gmoorman/sddec24-13/README_files/A_Brief_Excerpt_on_Mixed_Signal_Circuits_for_Xschem.pdf

# A Brief Excerpt on Mixed Signal Circuits for Xschem

# Synthesize Digital Components

## Update toolchain and PDKs

The first step is to ensure the environment dependencies are updated. At the time of writing, it can be confirmed this mixed-signal method works with Toolchain version 1.0.4. In terms of the PDK, setup detailed in this document was used: Precheck Guide. (https://sddec24-13.sd.ece.iastate.edu/Precheck_reram%20precheck.pdf)

## Create digital components with OpenLane

Next, harden your digital macro with OpenLane. In this environment, the easiest way would be to follow the typical digital flow for the Carvel User Harness. To do so, you can clone and setup the following Caravel User Harness git repo: https://github.com/efabless/caravel.

Assuming the repository and PDKs have been setup properly you’ll want to ensure the following environment variables have been set:

You should then be able to follow the digital workflow as stated in the OpenLane documentation here: https://openlane.readthedocs.io/en/latest/usage/index.html
And this document from sddec23-06 detailing the digital flow using the Caravel User Harness: https://sddec23-06.sd.ece.iastate.edu/reports/492/UserGuide.pdf

## Verilog to Combinational Logic Circuitry

This process is relatively straight-forward and a guide by Stefan Schippers, the author of Xschem, can be found in this Slack discussion here: https://open-source-silicon.slack.com/archives/C017P3RAD42/p1715774213341429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 (https://open-source-silicon.slack.com/archives/C017P3RAD42/p1715774213341429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)

The following is a brief guide based on that video.

1) Once you’ve run through the digital design process, OpenLane should have spat out a gate-level Verilog netlist. This can generally be found in the following directory:

/caravel_user_project/openlane/MODULE/runs/MODULE/results/final /verilog/gl/

2) From here, there may be two files.
MODULE.nl.v and MODULE.v
You’ll want to take the powered netlist, and this is usually MODULE.v. You can verify this by comparing the two files. The unpowered netlist should have the following comment.
3) Copy this netlist file into your Xschem directory (or wherever your .xschemrc)
4) Run awk script with the Verilog netlist with the following command ./make_sky130_sch_from_verilog.awk MODULE.v
This will generate the schematic and subsequent symbol for your module.
You should see something similar to the following should the operation be successful.

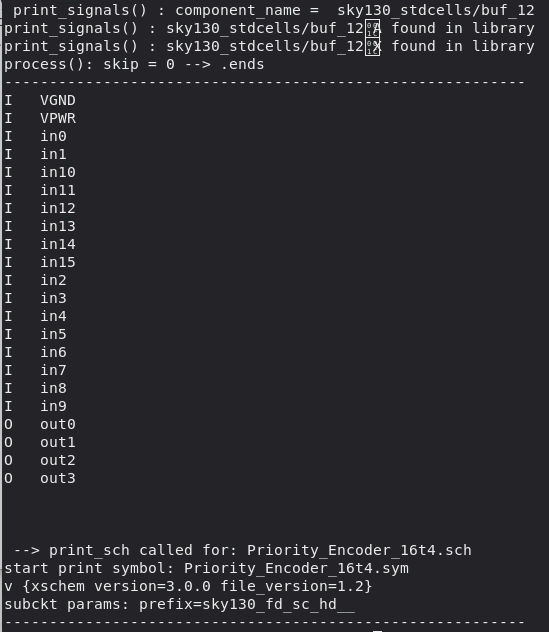
[picture p27: figure]

5) Open your schematic in Xschem and remove non-functional cells like fillers and taps as such:
- Select all non-functional cells by “CTRL+F” and filling out the following form
- Once selected, you can delete these cells

6) Open your symbol and change your symbol type from “primitive” to “subcircuit”
- You can edit this attribute by pressing “Q” in the .sym folder to pull up the following dialog

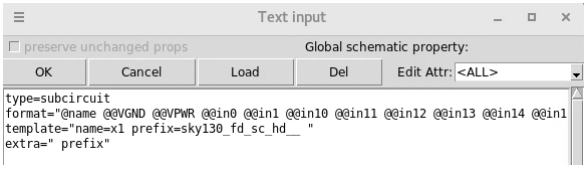
[picture p28: figure]

7) Finally, when you place the attributed symbol in a testbench, ensure that you place a code.sym with the following input:

name=STDCELLS
only_toplevel=true
format="tcleval( @value )"
value=" ** opencircuitdesign pdks install .include
$::SKYWATER_STDCELLS/sky130_fd_sc_hd.spice "
spice_ignore=false
