gmoorman/sddec24-13/README_files/sddec24-13_final_492_presentaion.pdf

# ReRAM Compute ASIC

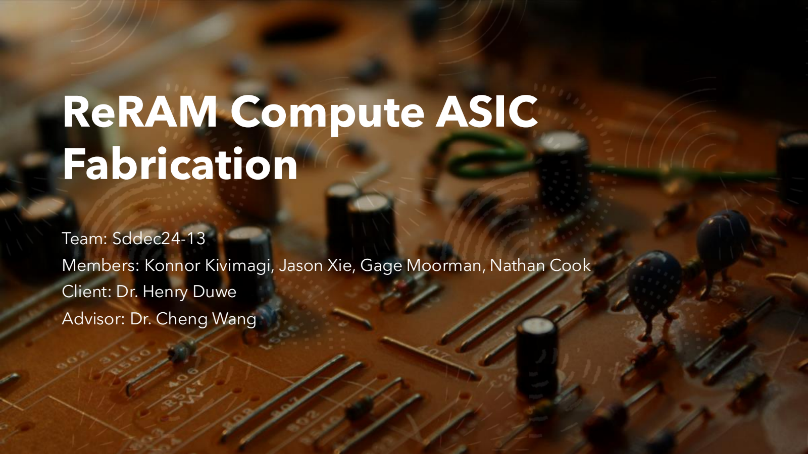
[picture p35: page 1]

# Fabrication

Team: Sddec24-13
Members: Konnor Kivimagi, Jason Xie, Gage Moorman, Nathan Cook Client: Dr. Henry Duwe
Advisor: Dr. Cheng Wang

# Project Overview

- Problem
- ReRAM is an emerging memory technology
- Not commercially available
- Has the potential to be used in more efficient in-memory computation
- Goals
- Create a research vehicle for silicon proving in memory computation utilizing ReRAM
- Create documentation on our process and on solutions to common issues

# Broad context

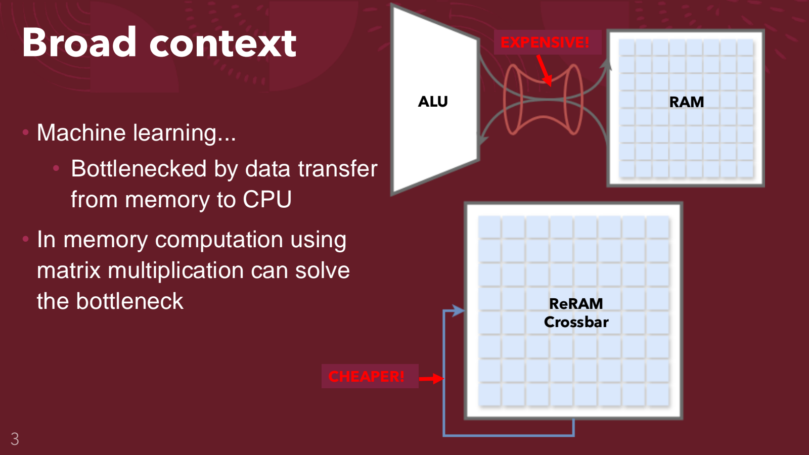
[picture p36: page 3]

- Machine learning...
- Bottlenecked by data transfer from memory to CPU
- In memory computation using matrix multiplication can solve the bottleneck
ALU | RAM

EXPENSIVE!

ReRAM
Crossbar

CHEAPER!

# ReRAM

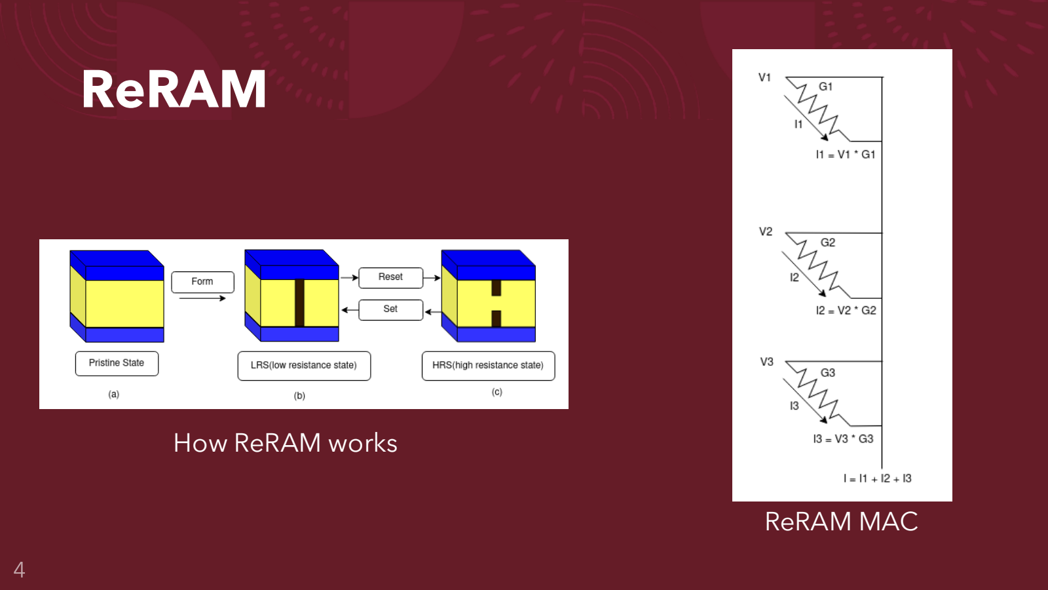
[picture p37: page 4]

How ReRAM works

ReRAM MAC

# ReRAM pros and cons

Pros | Cons
High memory density | Variation due to random noise
Non-volatile memory | Different manufacturing process
Low power consumption | Not an established technology
Ability to scale to smaller processes

Still an active research area, hope to further enable solutions with this test chip

# Users

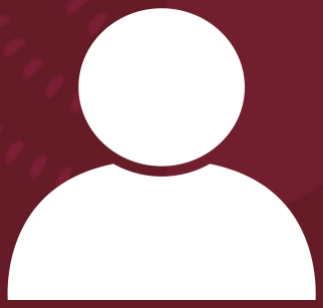
[picture p38: figure]

- Graduate Students
- Documentation on Efabless process and tool flow for use in research settings
- Undergrad Students
- Easy to follow lab documentation
- Gain the ability to bring up a chip in parallel with their regular coursework
- Professor Duwe and Professor Wang
- Practical example of a crossbar for research and testing
- Provide valuable resources for the co-curricular chip program

# Requirements

- Functional Requirements
- Design an 8x8 ReRAM crossbar that can perform matrix vector multiplication
- Create an ADC with a sufficiently high resolution to distinguish between all possible MAC output values
- 40 MHz clock speed
- Fit within 1/8th the provided area
- Characterization of peripheral circuits
- Non-functional Requirements
- Project Documentation
- Bring-up plan for testing the fabricated chip

# Efabless Fabrication

Efabless runs a shuttle program every
few months
- Low-cost development
- Projects are required to be open-source
- Uses open Skywater 130nm process

Design Process
- Create a design
- Integrate it into the caravel harness
- Submit for fabrication

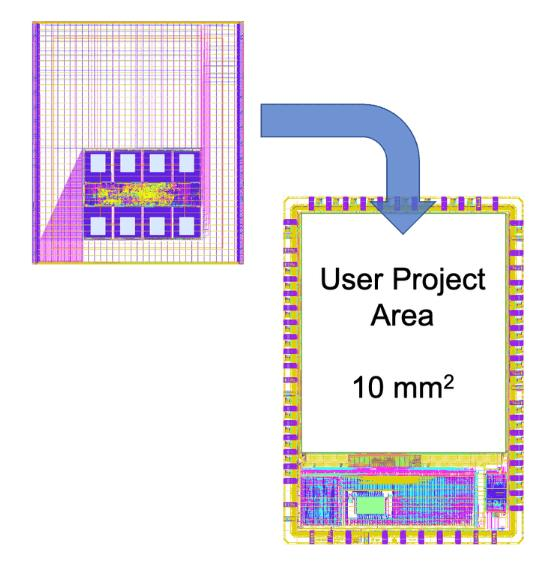
[picture p39: figure]

Source 1

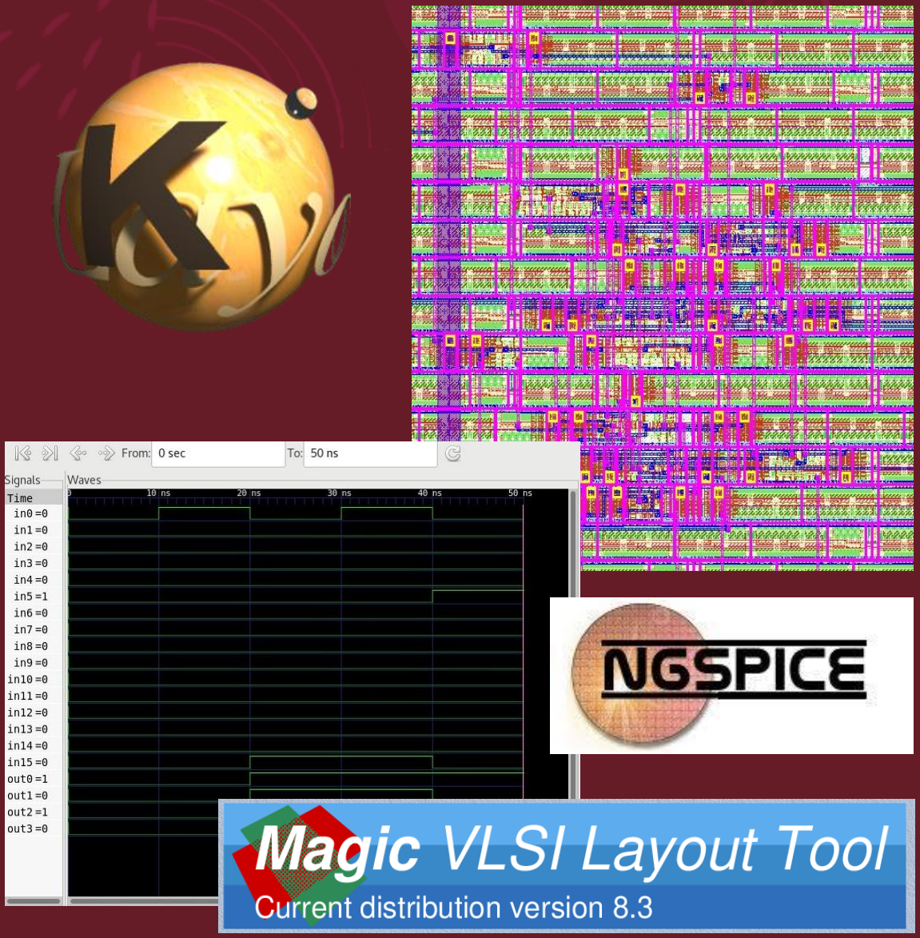
[picture p40: figure]

# Design Tools

- Xschem - Schematic capture
- Netgen – Used for LVS
- Ngspice – Spice simulator
- Magic - Layout creation
- Klayout – GDSII viewer
- GTKwave – Verilog waveforms

# Efabless Design

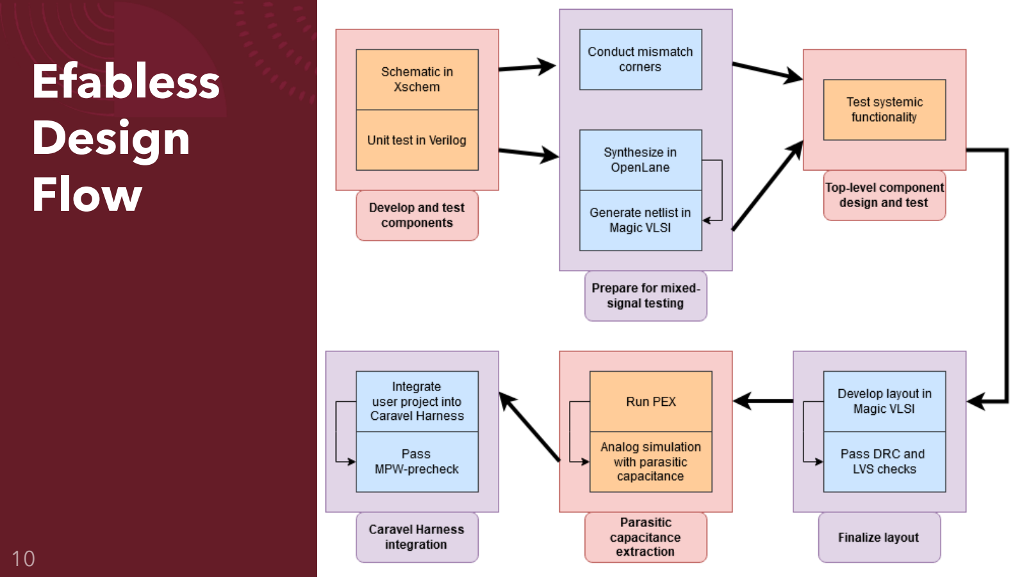
[picture p41: page 10]

# Flow

10

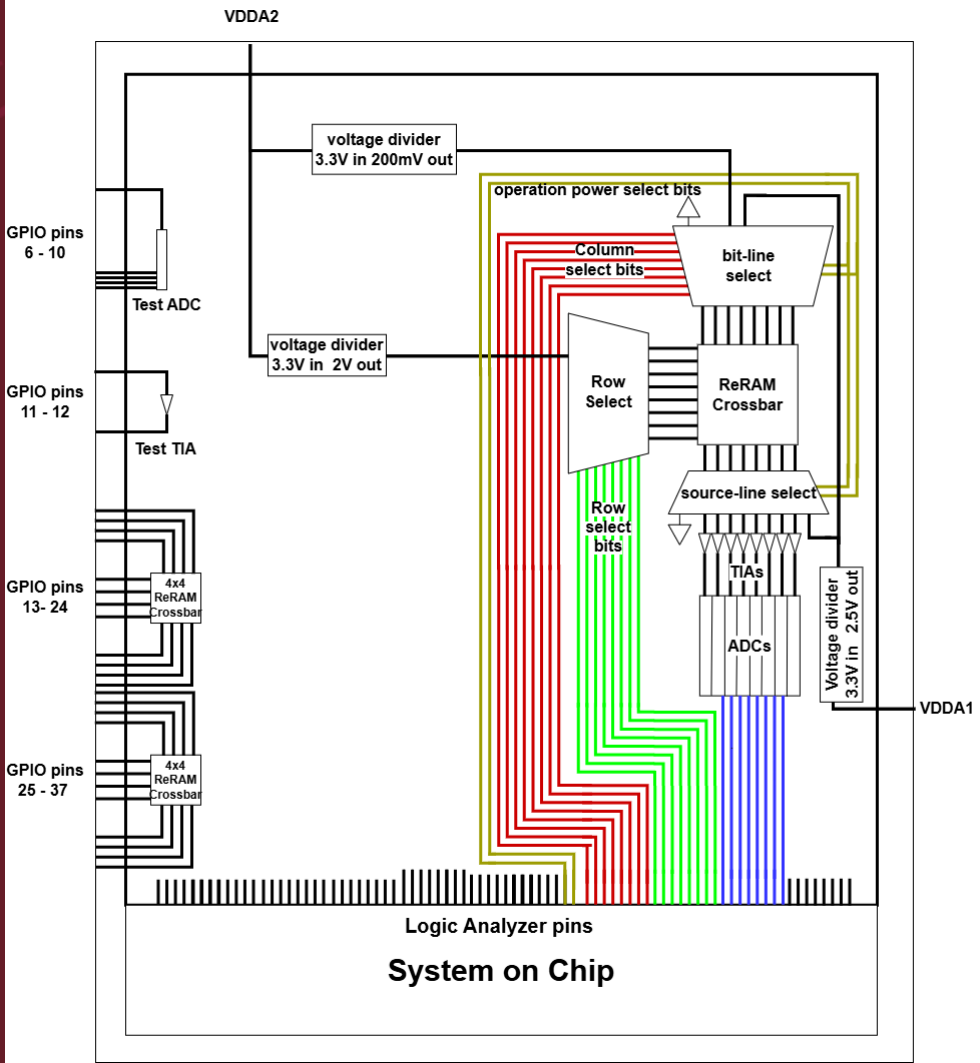
[picture p42: figure]

- Control circuits – Logic analyzer, row, power, and column select, decides what operation is performed
- DAC – used during standalone operation
- Power select – selects the voltage values being used
- ADC and TIA network – Convert ReRAM analog output to a logic analyzer compatible digital output

# Top level design

## Crossbar

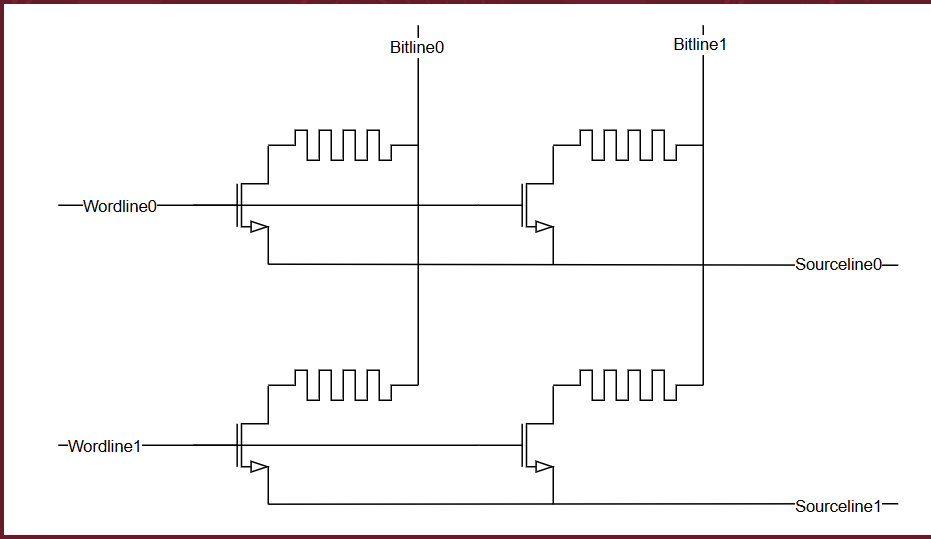
[picture p43: figure]

- 8x8 used for our
design

# The ReRAM cell

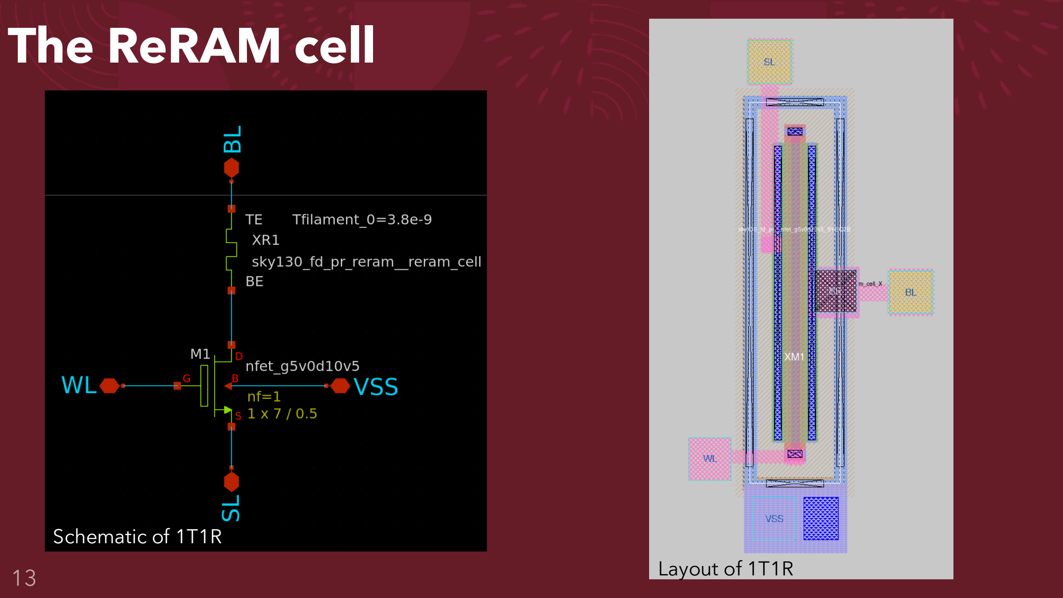
[picture p44: page 13]

Schematic of 1T1R
Layout of 1T1R

# ReRAM operations

Write – set
- Positive voltage
across the cell
- Wordline selects row


ReRAM set

# ReRAM operations

Write – reset
- Negative voltage
across the cell
- Wordline selects row

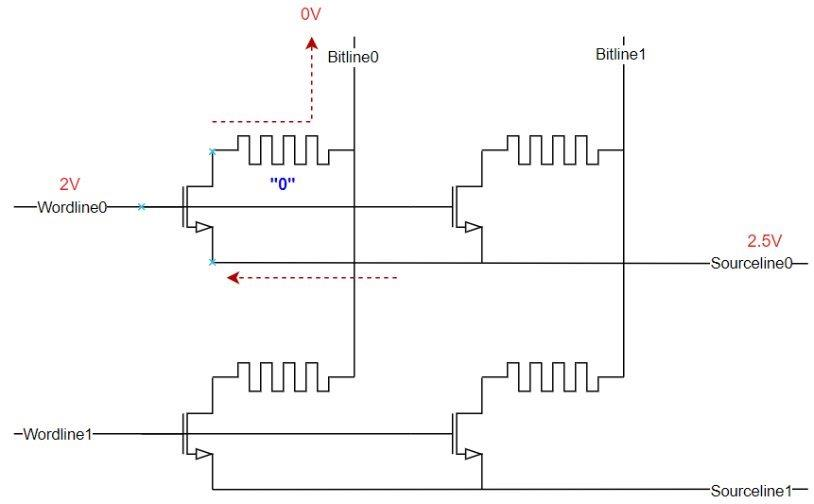
[picture p45: figure]

ReRAM reset

# ReRAM Operations

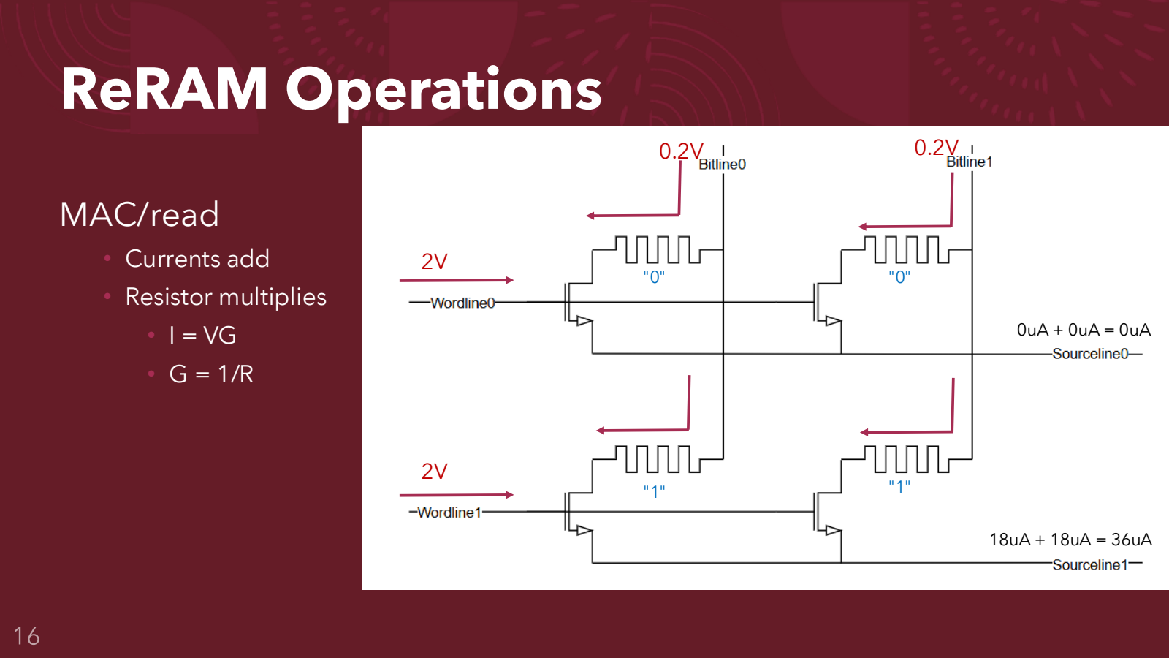
[picture p46: page 16]

MAC/read

- Currents add
- Resistor multiplies
- I = VG
- G = 1/R

2V

2V

0.2V

"1"

0.2V

"1"

"0" | "0"

0uA + 0uA = 0uA

18uA + 18uA = 36uA

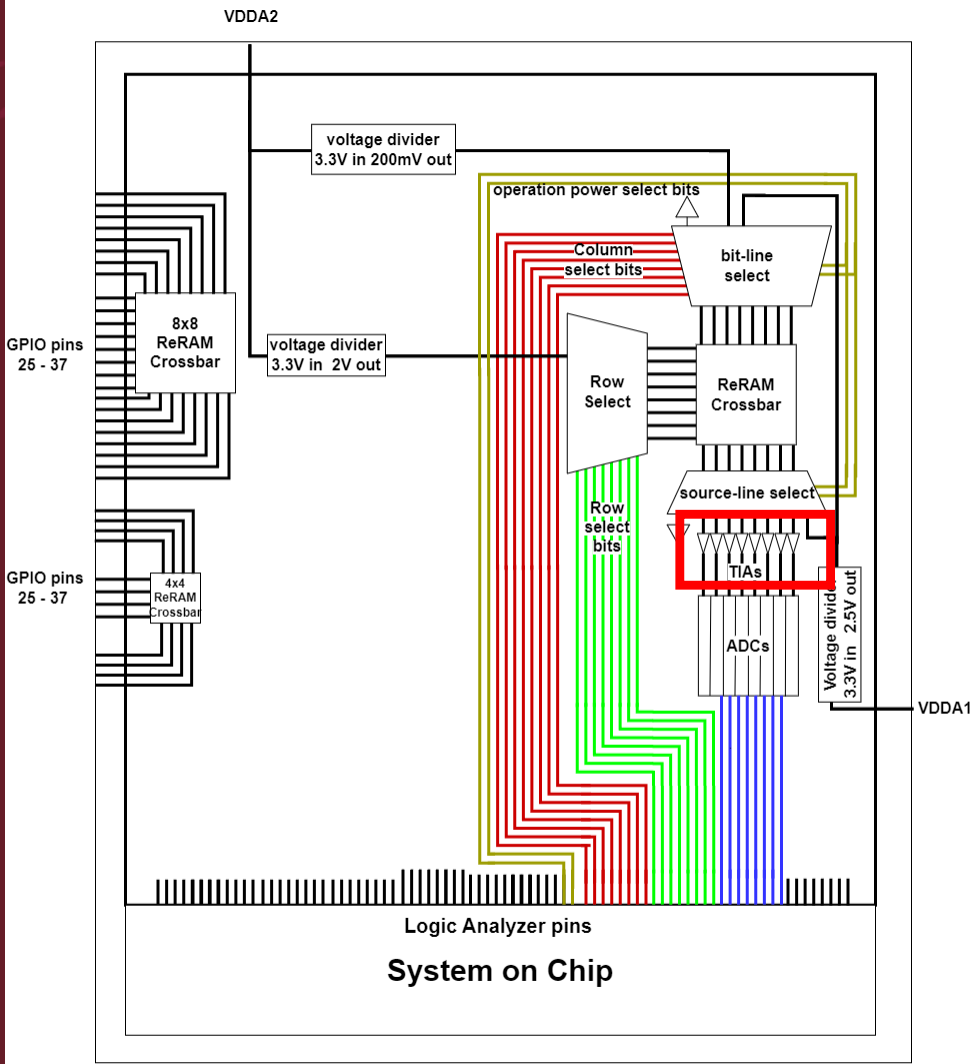
[picture p47: figure]

- Converts input current to output voltage
- Desired TIA characteristics
- Linear output
- High trans-impedance gain
- Low input impedance

## Trans-Impedance Amplifier (TIA)

## Trans-Impedance Amplifier (TIA)

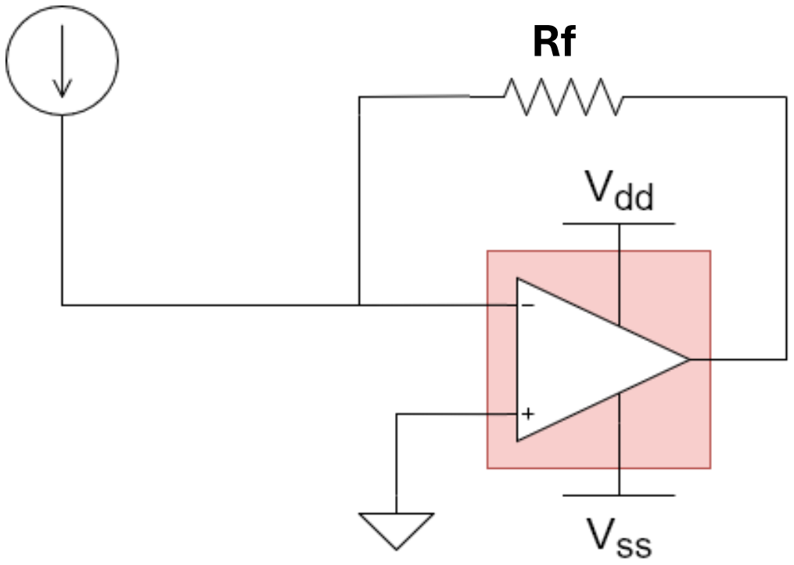
[picture p48: figure]

- Op-Amp Architecure Considerations
- 2 stage
- Increased Gain
- BW dependant on first

# Trans-Impedance Amplifier (TIA)

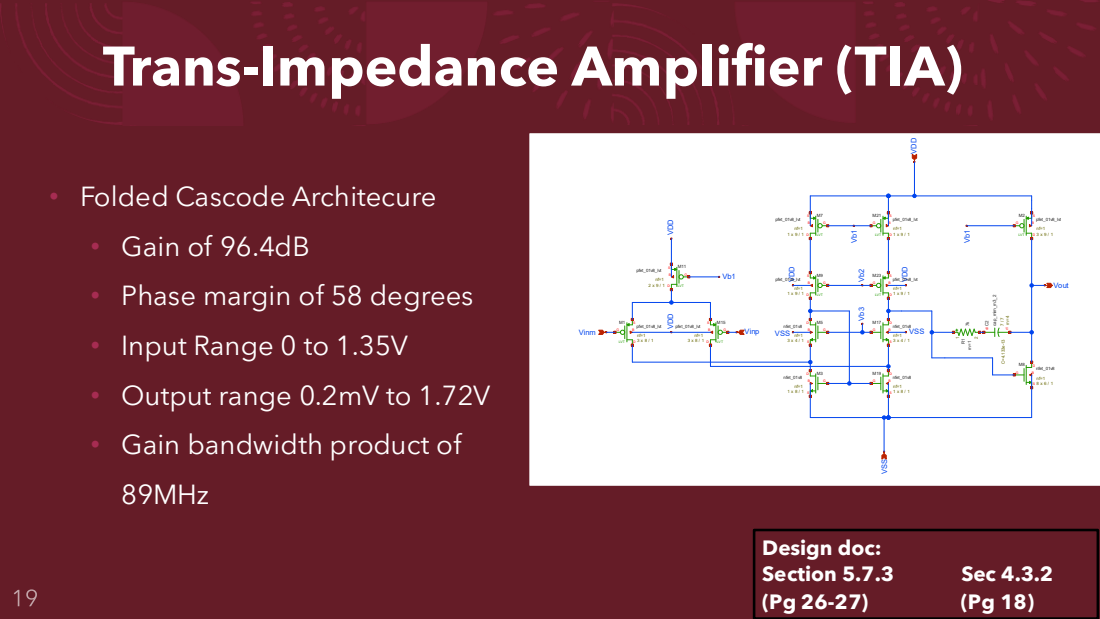
[picture p49: page 19]
Design doc:; Section 5.7.3; Sec 4.3.2

• Folded Cascode Architecure
• Gain of 96.4dB
• Phase margin of 58 degrees
• Input Range 0 to 1.35V
• Output range 0.2mV to 1.72V
• Gain bandwidth product of
89MHz

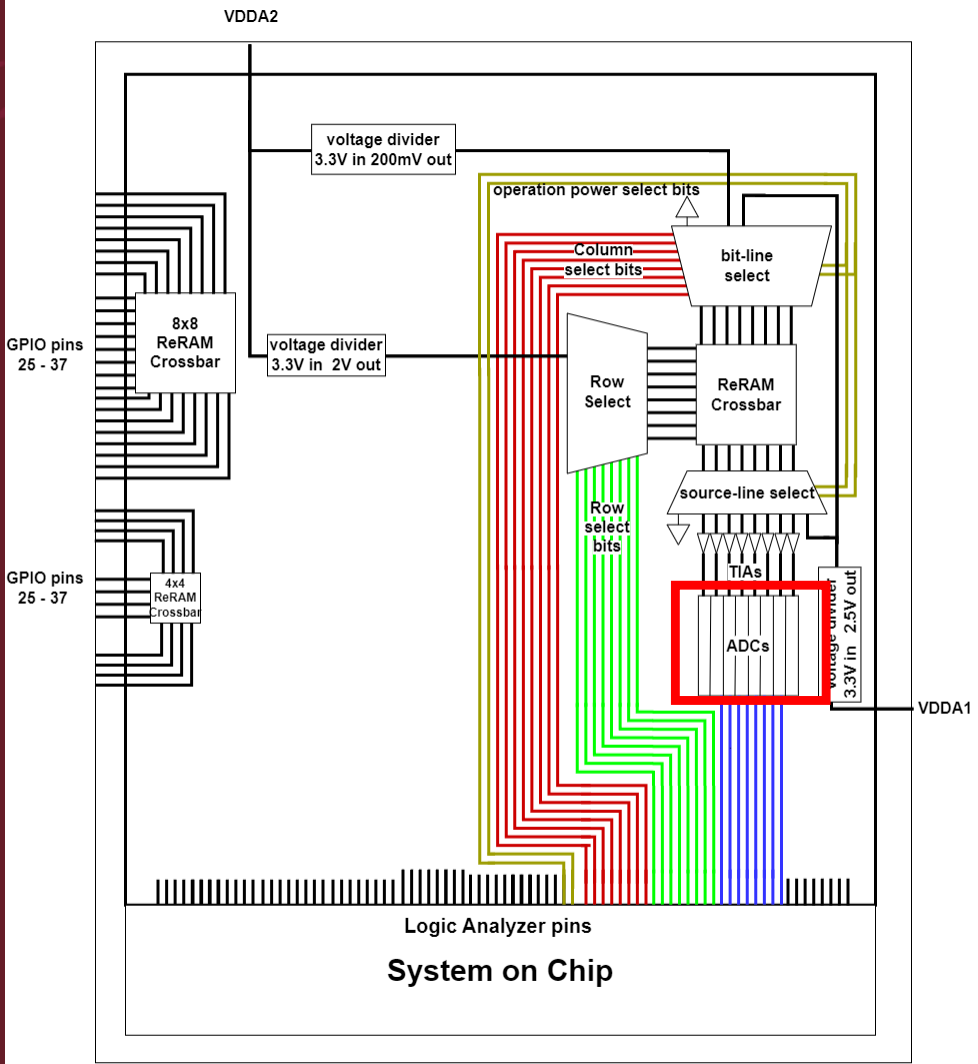
[picture p50: figure]

- Converts analog voltage to digital code
- Desired ADC characteristics
- Linear output
- 4 effective number of bits (ENOB)
- Sampling frequency of
40MS/s
- No missing codes

## Analog to Digital Converter

- Flash ADC
- Simple
- Fast
- 4-bit resoultion
- Integral non-linearity (INL) 0.62 LSBs
- Effective number of bits (ENOB) based INL 3.69
- Measured at 40MS/s sampling Rate

# Analog Digital Converter

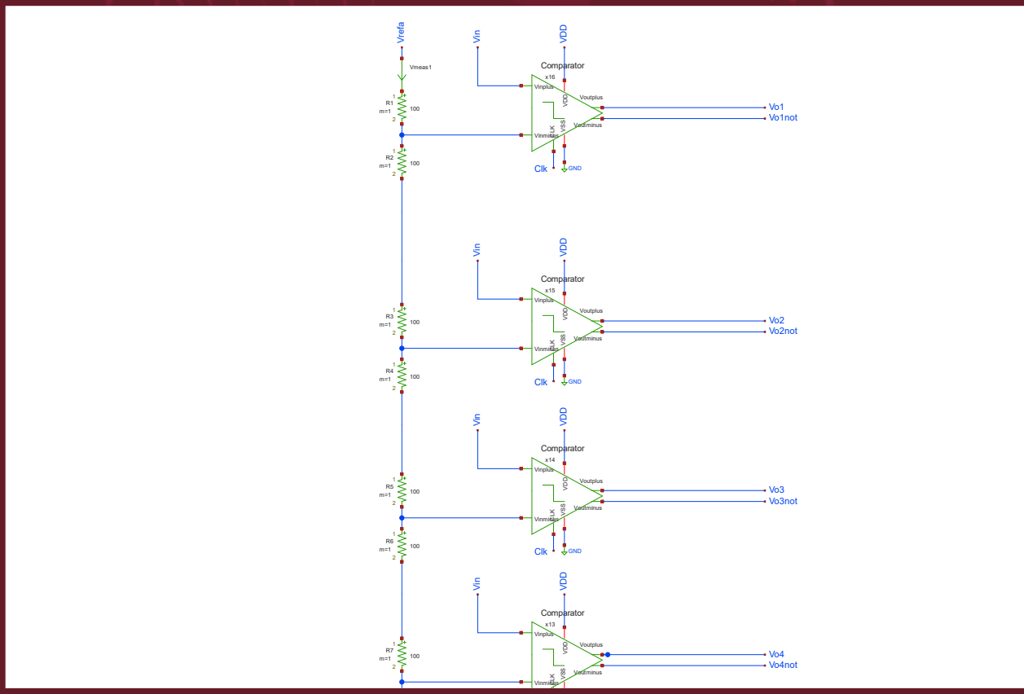
[picture p51: figure]

Design doc:
Section 5.7.5 | Sec 4.3.2
(Pg 28-30) | (Pg 16-17)

## Comparator

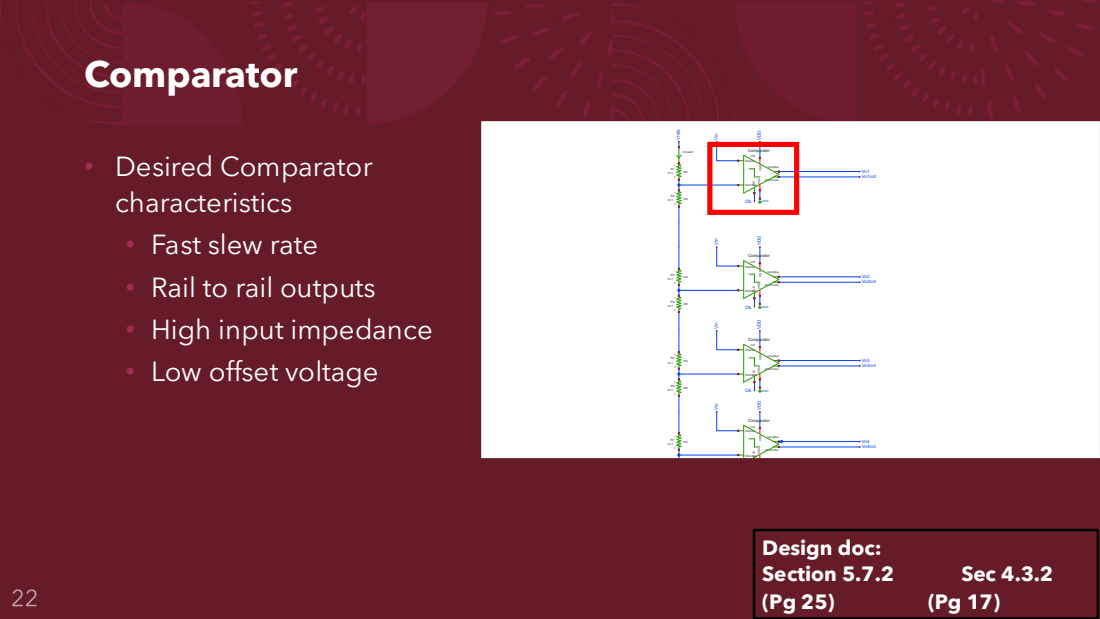
[picture p52: page 22]
Design doc:; Section 5.7.2; Sec 4.3.2

• Desired Comparator
characteristics
• Fast slew rate
• Rail to rail outputs
• High input impedance
• Low offset voltage

## Comparator

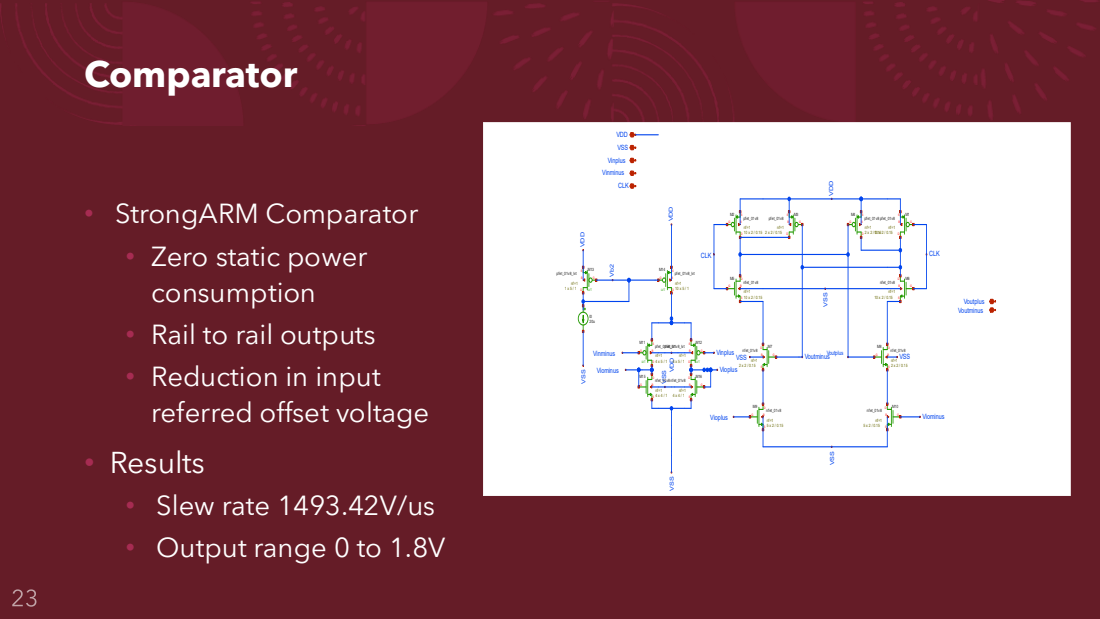
[picture p53: page 23]

• StrongARM Comparator
• Zero static power
consumption
• Rail to rail outputs
• Reduction in input
referred offset voltage
• Results
• Slew rate 1493.42V/us
• Output range 0 to 1.8V

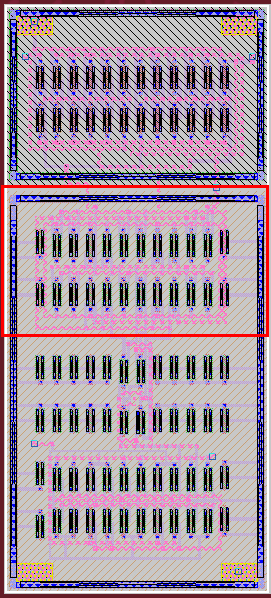
[picture p54: figure]

# Comparator Layout

- Implemented using a
common centroid approach
- Approach aimed to decrease effects of mismatch
- Requires parallel device interconnections and dummy devices
- Created a TCL script to assist device generation and
placement in Magic VLSI
- Not an ideal solution

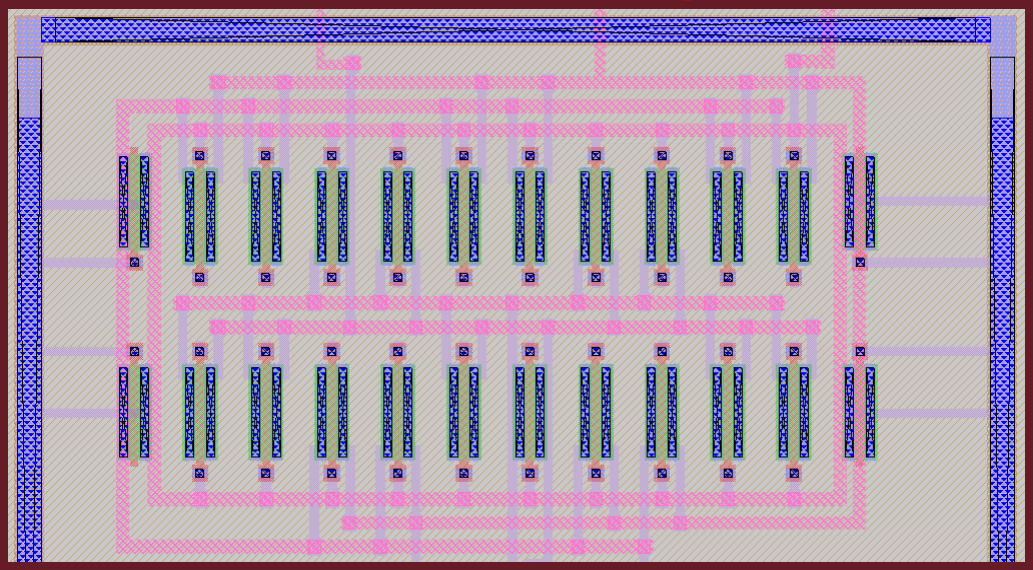
[picture p55: figure]

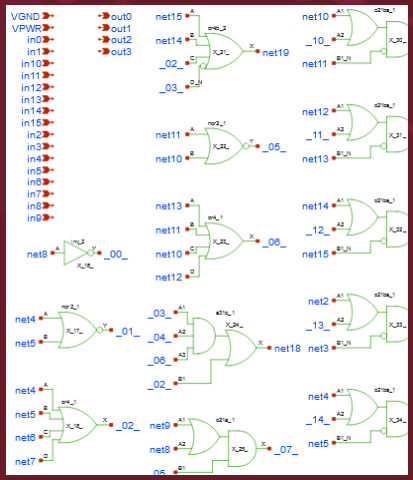
[picture p56: figure]

Priority Encoder • Converts to binary encoding • Fully digital component • Verilog to combinational

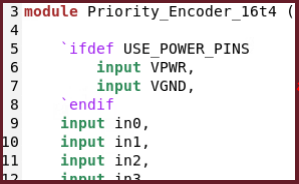
[picture p57: figure]
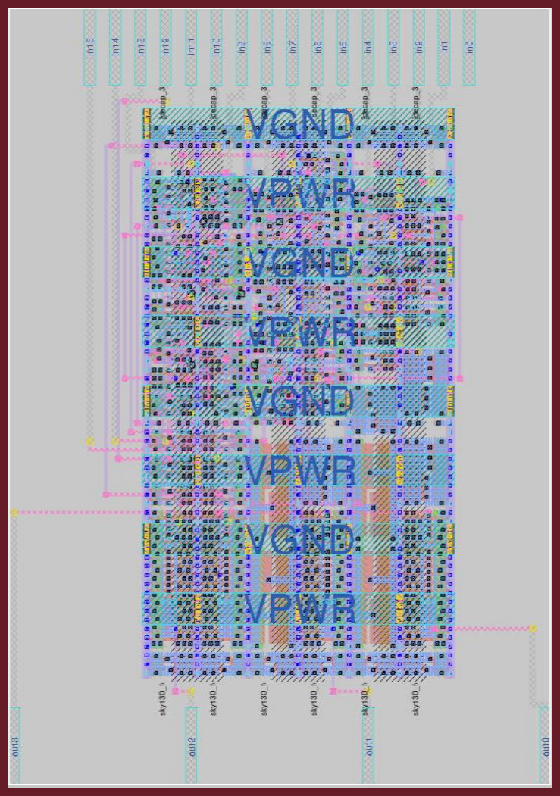
[picture p58: figure]

circuit conversion
achieved with an .awk
script
- Synthesized and hardened through Openlane

# ADC Layout

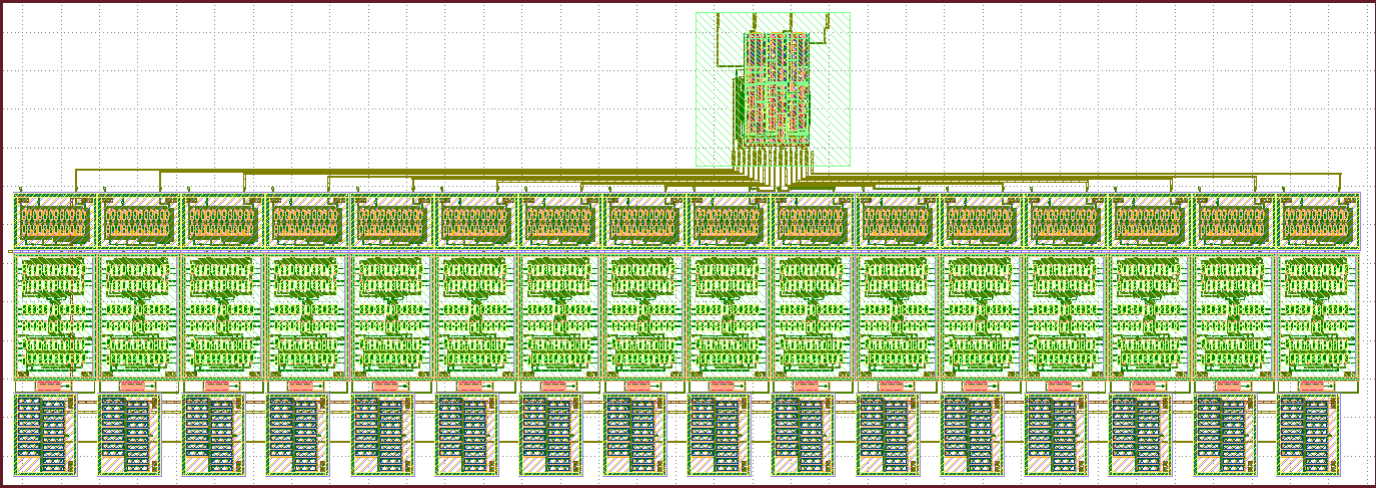
[picture p59: figure]

# System on Chip

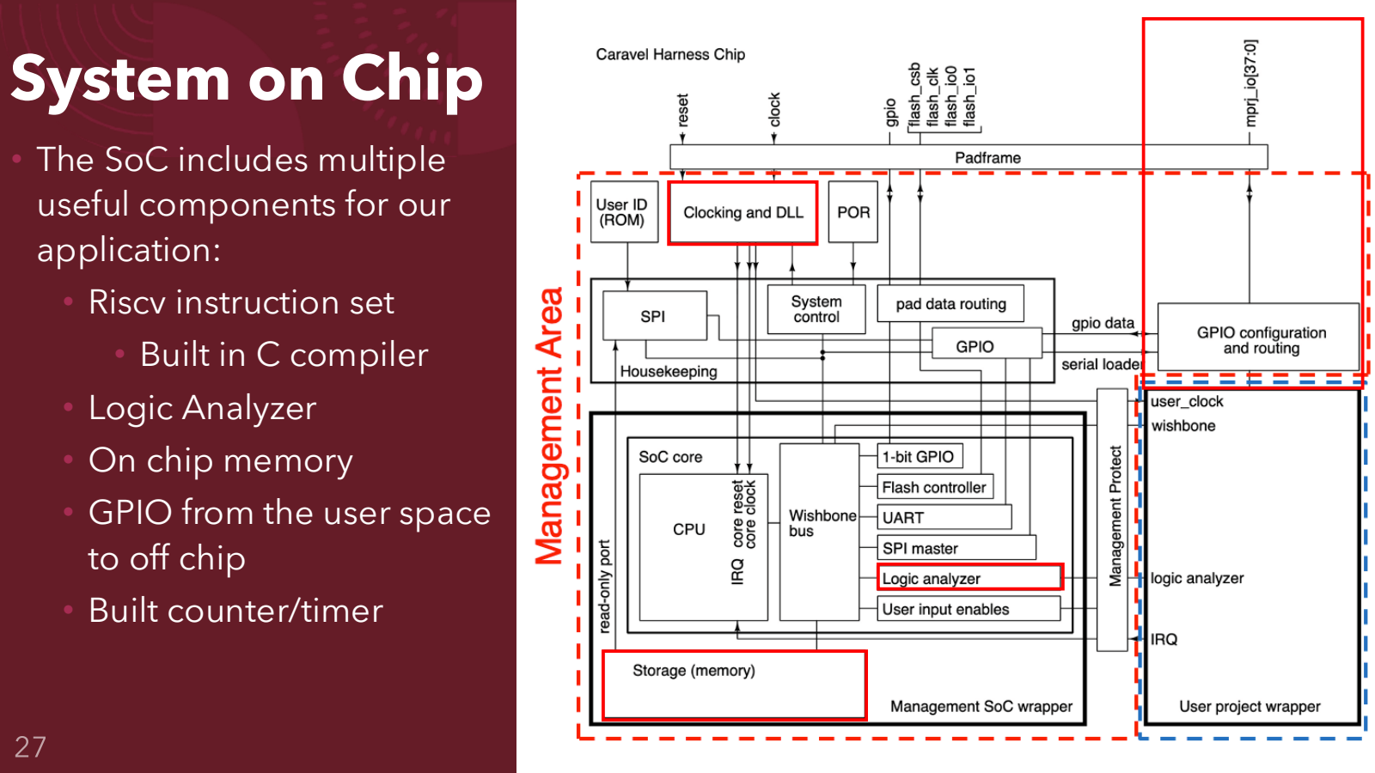
[picture p60: page 27]

- The SoC includes multiple useful components for our
application:
- Riscv instruction set
- Built in C compiler
- Logic Analyzer
- On chip memory
- GPIO from the user space to off chip
- Built counter/timer

# Noise breakdown

- There are 4 sources of noise present in our device:
- Thermal noise, shot noise, and flicker noise are not significant enough to effect our design
- Skywater has clear temperature ranges for device operations
- Random Telegraph Noise (aka burst noise)
- The sky130nm technology uses halfnium-oxide memristors
- Memristors like hafnium-oxide are more susceptible to RTN
- Best way to effectively characterize noise in our device is to test the physical devices acquiring characterizations for it in the process.

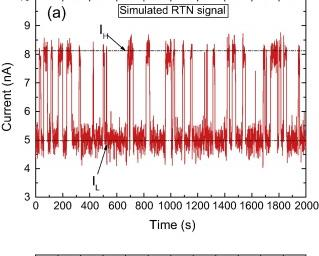
[picture p61: figure]

[7] M. Maestro et. al (https://www.sciencedirect.com/science/article/pii/S0038110115002385)

# Risk Mitigation

- Memristor and CMOS Modeling Issues
- Risk: Inaccurate device models caused by the use of binning models and BSIM4
- Mitigation: Explore open-source SPICE models, document current issues, propose future solutions.
- Fabrication Errors
- Risk: Fabrication defects that aren't attributed to our design
- Mitigation: Detailed bring-up plan with testing methods, acknowledge limitations in preventing fabrication errors.

# Conclusion

- 8x8 crossbar was designed and tested as well as being verified to pass precheck
- Created appropriate periphery devices to interface with the crossbar
- Created documentation on our design as well as solutions to any common issues to help reduce future teams struggles

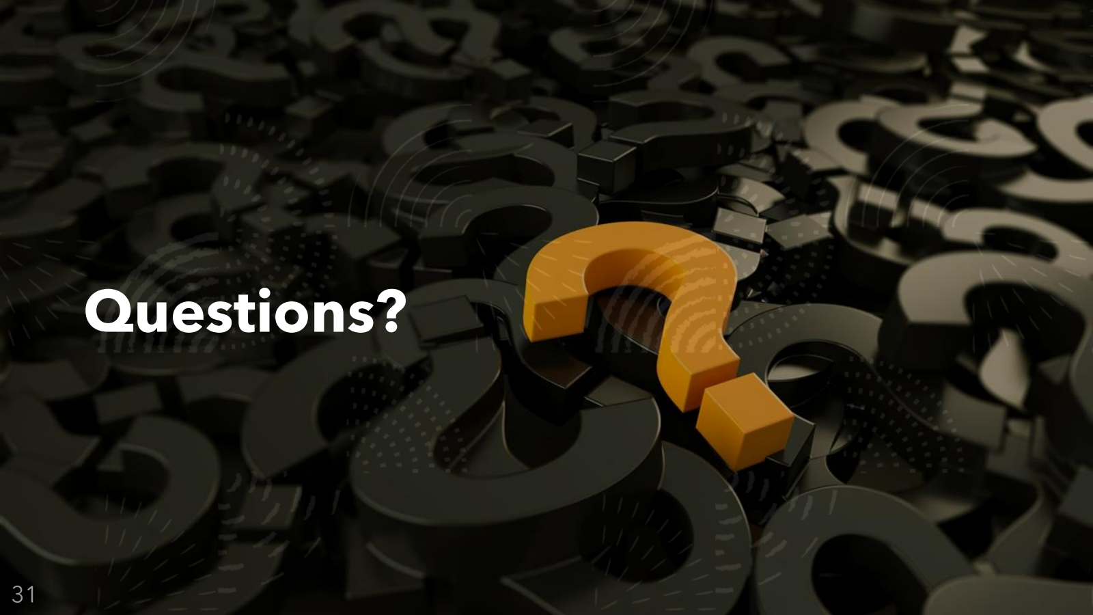
[picture p62: page 31]

# Questions?

# Supplementary Slides

# 8x8 Layout

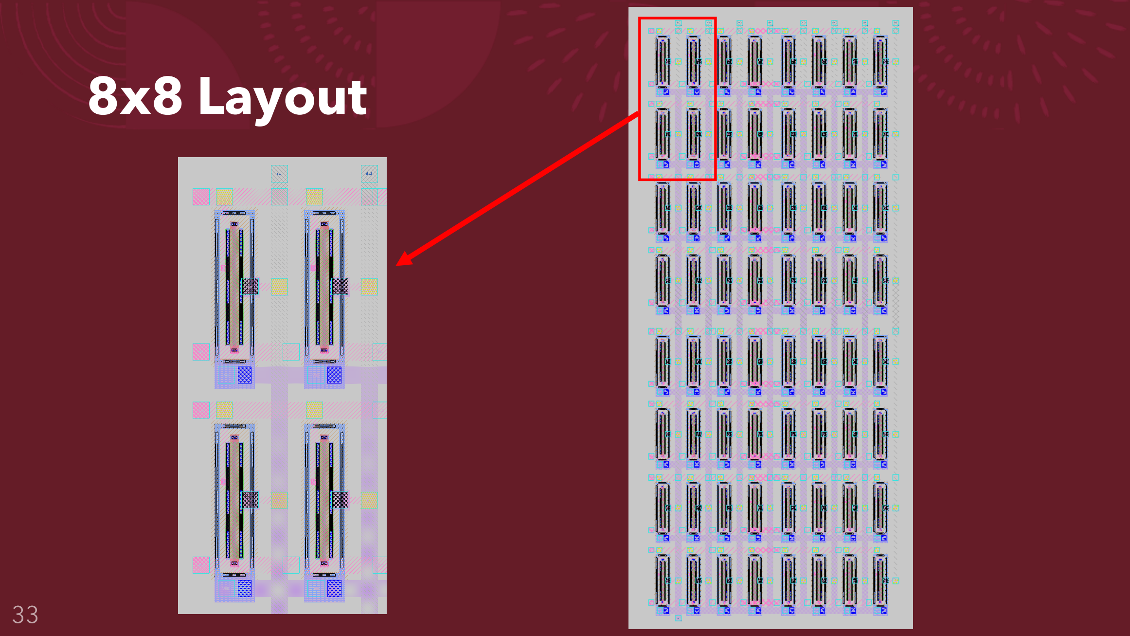
[picture p63: page 33]

# ReRAM Simulation Issues

- ReRAM is unable to be simulated correctly
- Due to transistor models inherently being hard coded as one directional
- See section 5.7.1 in the design document

# ADC layout

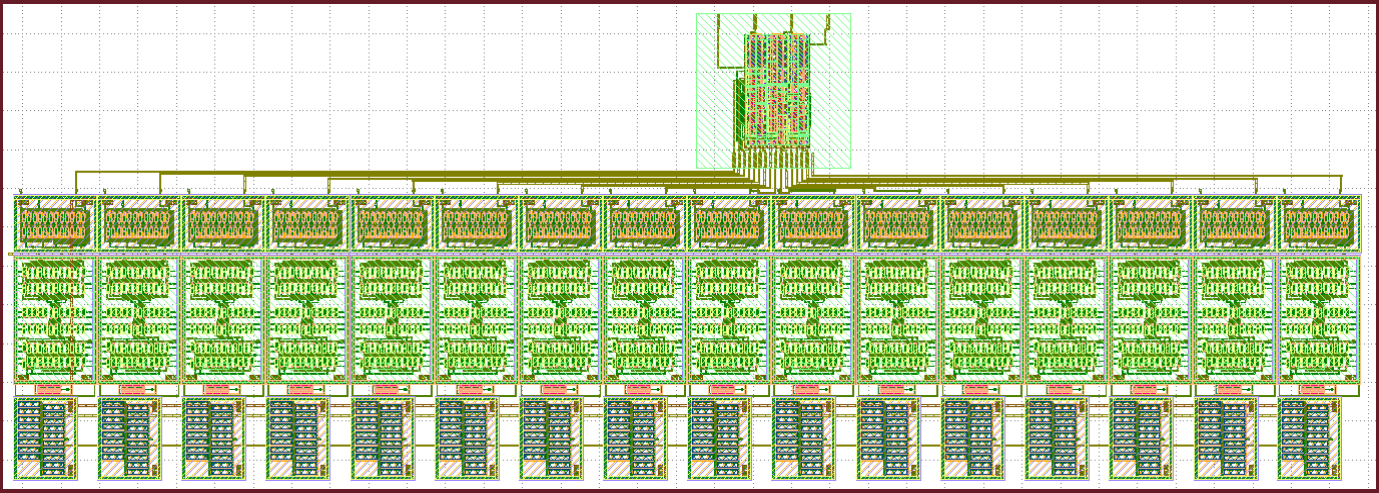
[picture p64: figure]

# Definitions

- DRC : Design Rule Check
- LVS: Layout vs Schematic
- MPW: Multi-Project Wafer
- Efabless: Chip design company
- ReRAM: Resistive Random Access Memory
- ASIC: Application Specific Integrated Circuit
- ADC: Analogue to Digital Converter
- DAC: Digital to Analogue Converter
- TIA: Transimpedance Amplifier

# Timeline

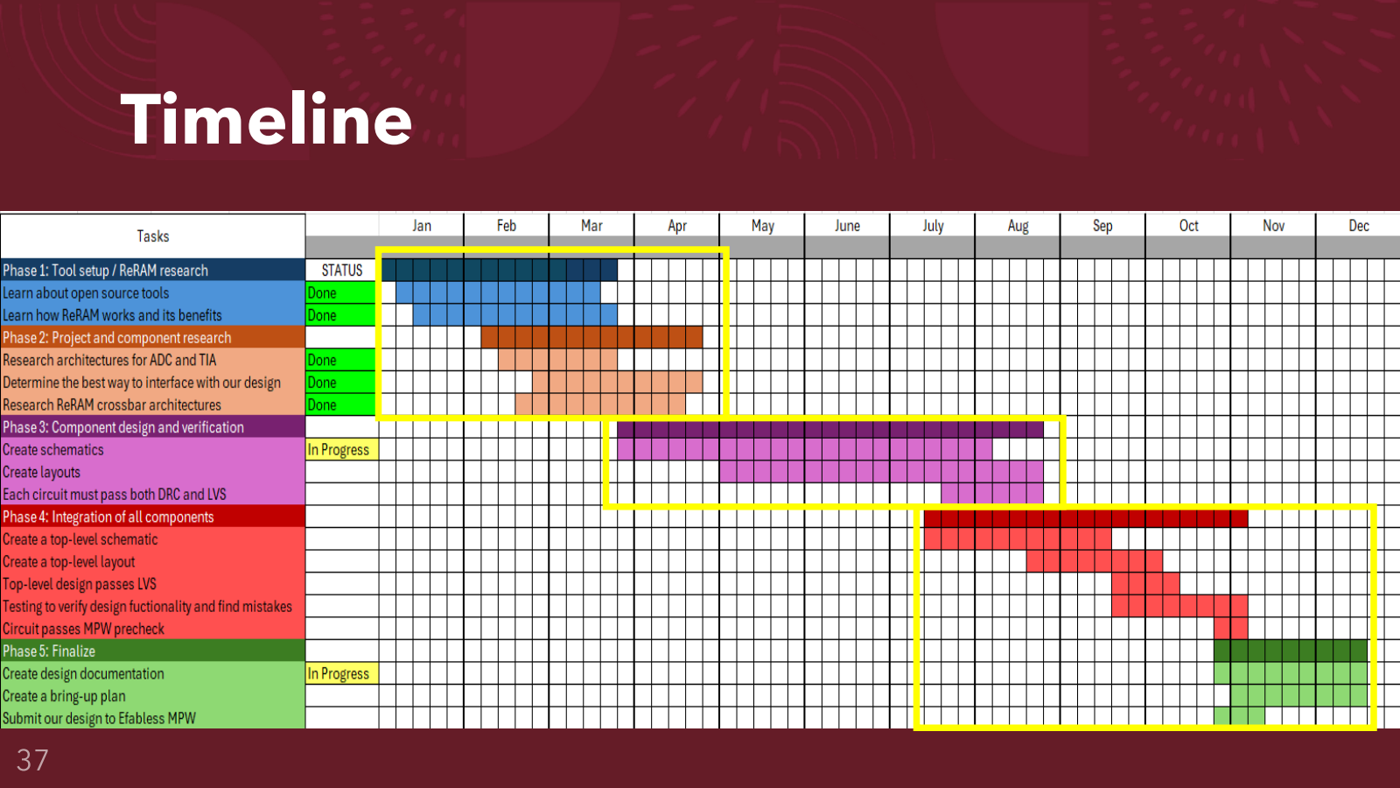
[picture p65: page 37]

# Contributions – Gage Moorman

- ADC design and test
- TIA design and test

# Contributions – Konnor Kivimagi

- Fixed ReRAM precheck issues
- Analog tool setup
- Designed and simulation of the ReRAM crossbar

# Contributions – Nathan Cook

- Noise analysis
- SoC integration
- Embedded Code development

# Contributions – Jason Xie

- Analog layout
- Digital tool setup

# ReRAM IV Curve

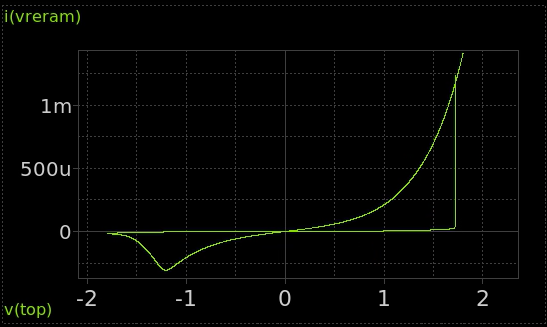
[picture p66: figure]

# Sources

1) https://efabless.com/chipignite
2) https://web.eecs.umich.edu/~zhengya/papers/chou_micro19.pdf
3) http://opencircuitdesign.com/magic/
4) https://semiwiki.com/semiconductor-manufacturers/tsmc/287672-in-memory-computing-for-low-power-neural-network-inference/ (https://semiwiki.com/semiconductor-manufacturers/tsmc/287672-in-memory-computing-for-low-power-neural-network-inference/)
5) Tony Chan Carusone, D. Johns, and K. W. Martin, Analog integrated circuit design. Hoboken, Nj Wiley, 2012.
6) B. Razavi, "The StrongARM Latch [A Circuit for All Seasons]," in IEEE Solid-State Circuits Magazine, vol. 7, no. 2, pp. 12-17, Spring 2015, doi: 10.1109/MSSC.2015.2418155.
7) https://www.sciencedirect.com/science/article/pii/S0038110115002385
