gmoorman/sddec24-13/README_files/Precheck_reram_precheck.pdf

# Precheck guide

Install Volare and create the correct PDK: | 2
Update Makefile: | 2
Install volare and make PDK: | 2
Setup and run precheck: | 3
Make precheck: | 3
Prepare to run precheck: | 3
Run precheck: | 5
Reram precheck LVS errors and solutions: | 5
Property errors: | 5
Disconnected nodes: | 6
Link to slack channel involving this information: | 7

## Install Volare and create the correct PDK:

### Update Makefile:

The first important step is to update your Makefile which is located in the caravel_user_project_analog directory or caravel_user_project for digital projects. In this file there are two things that need to be changed, the MPW_TAG variable and the OPEN_PDKS_COMMIT variable. These are both located at the top of the file and at the time of writing should be changed to match the images below.

IMPORTANT: These may change with time and you’ll have to monitor or ask on slack if something has changed.

### Install volare and make PDK:

Now that the makefile is updated we can run the following commands to install volare and make the correct version of the PDK. First we must set some global variables in order to place things in the correct spots.

- PDK_ROOT will be the directory where you install the PDK
- PDK is set to either sky130B or sky130A for our purposes we use sky130B
- CARAVEL_ROOT should point to the caravel directory located in the same directory as the Makefile we edited previously
Once these variables are set run the following command to install volare.

After this is complete run | to verify that it installed correctly. If nothing happens
you will need to add the directory that volare installed to to your path. The command for that will look similar to the following. In my case volare installed to .local/bin.

A successful volare ls should look similar to this:

Now we are going to create the PDK. Run the following command.

The output should look like something like this:

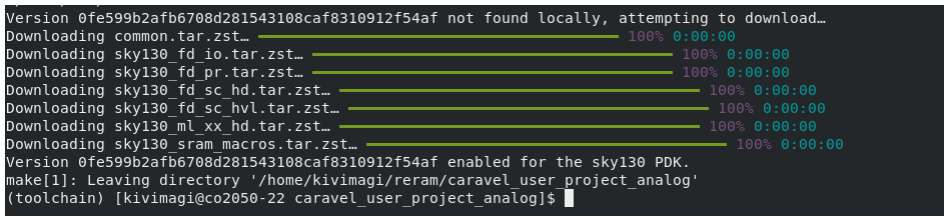
[picture p67: figure]

You should be able to see that the value we set OPEN_PDKS_COMMIT to in the makefile is the version that has been enabled.

## Setup and run precheck:

### Make precheck:

Next we will create the precheck. To do this run the command
- make precheck
From the caravel_user_project_analog directory. From this point unless otherwise specified everything will be run from this directory. If successful this should create a directory called mpw_precheck in your home directory.

### Prepare to run precheck:

There are a few files that need to be edited or placed into the proper locations before we can run precheck.

Layout and schematic files:

If you have gotten to this point you should have created these two files:
- user_analog_project_wrapper.gds
- user_analog_project_wrapper.spice
Precheck is very particular about where these files are located so it is important that they are placed in the correct spots.

The user_analog_project_wrapper.spice file created from the schematic should be placed into the xschem directory as well as the netgen directory, if there is already a file here named that either overwrite it or remove it before copying your file there.

NOTE: The file copied to netgen must have all comments removed from it. These are any lines that start with either an * or a **. If you do not do this the precheck will throw an error.

The user_analog_project_wrapper.gds file needs to be placed into the gds directory and should be the only thing in that directory. Once again remove or overwrite any files that are already there, if applicable.

Edit user_defines.v:

There is a file called user_defines.v that must be updated in order to pass the precheck. It is located here:
- ~/caravel_user_project_analog/verilog/rtl/user_defines.v
This file is used for determining what what mode the GPIO pins will operate as such as input output, bidirectional etc. The value GPIO_MODE_INVALID in Lines 55-90 needs to be changed to one of the variables given at the top of the file based on what you want the pin to operate as. These picture show an example where all pins have been set to bidirectional pins.

Unset:

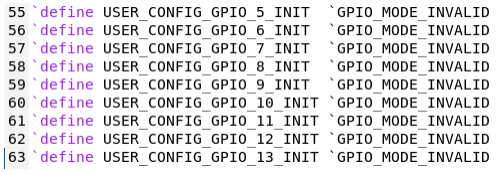
[picture p68: figure]

Bidirectional:

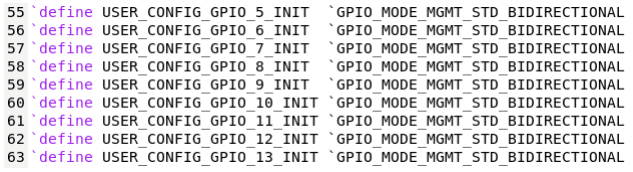
[picture p69: figure]

Edit Readme.md:
This is a simple one the default Readme file just need to be updated to a description of your project. Something more in depth or as simple as this:

### Run precheck:

Run the following command to start precheck:
- make run-precheck
If you have done all the steps correctly you should be able to pass precheck for any design that does not include reram cells.

## Reram precheck LVS errors and solutions:

Reram cells require a little more effort to push though precheck. This will cover the potential errors that can happen and how to solve them. The easiest way to find the error is from the lvs.report file, the location of which will be displayed in the terminal as the precheck runs.

### Property errors:

There are two property errors that can occur from the reram cell.

The first is a Tfilament error and looks like this:

If you run into this error, you have done something wrong in the steps above or you do not have the newest PDK version as this one is solved by using the correct PDK version given above

The second property error is the area_ox error and looks like this:

This means that there is a parameter in the user_analog_project_wrapper.gds file that does not match with the schematic side. To fix this we must add this parameter to the user_analog_project_wrapper.spice file located in the xschem directory.

Inside of user_analog_project_wrapper.spice there will be subcircuits that contain sky130_fd_pr_reram__reram_cell. For each sky130_fd_pr_reram__reram_cell the string area_ox=1 needs to be added at the end of the line. An example is shown below.

- Subcircuit:
- Sky130_fd_pr_reram__reram_cell line without update:
- Updated Sky130_fd_pr_reram__reram_cell line:
- Updated subcircuit:

### Disconnected nodes:

If LVS in your precheck is failing and you have something similar to this image in your lvs.report file:

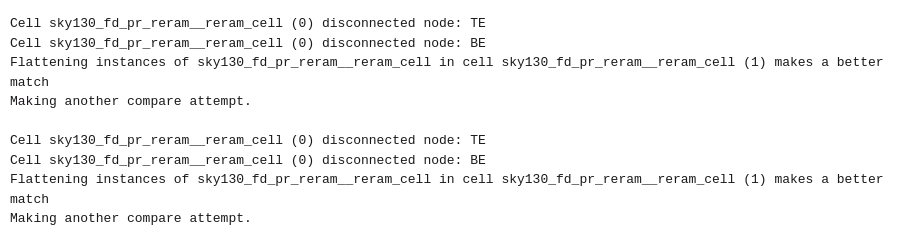
[picture p70: figure]

The solution is to remove the following code from your user_analog_project_wrapper.spice netlist.

Remove this:

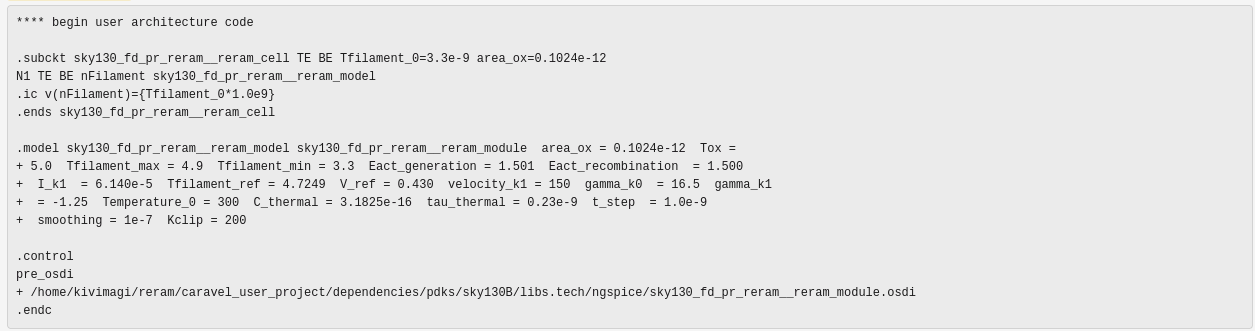
[picture p71: figure]

## Link to slack channel involving this information:

Slack Conversation (https://open-source-silicon.slack.com/archives/C032Y8J3KHA/p1725990362286459)
