gmoorman/sddec24-13/ADCschSmall.png

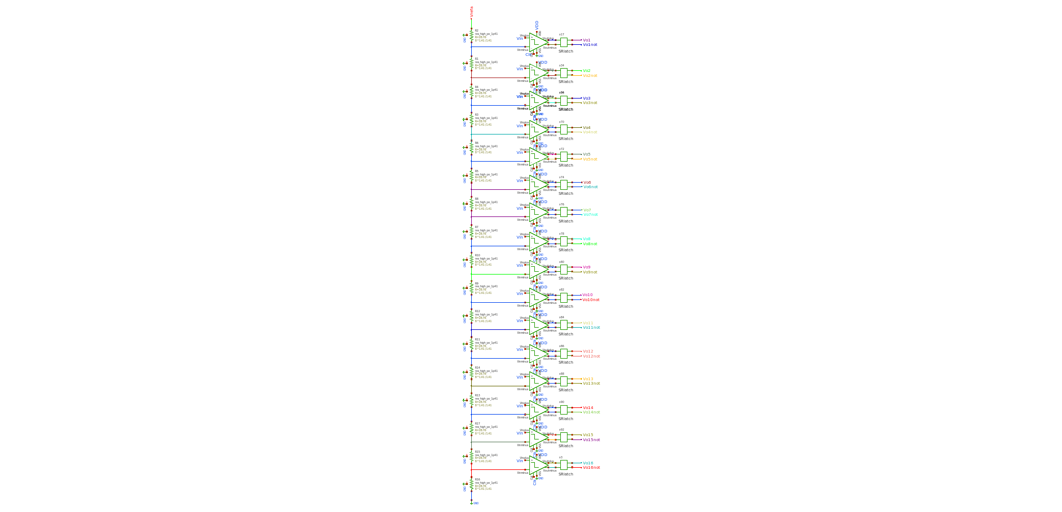
ADCschSmall.png
