gmoorman/sddec24-13/ADCschSmallPart.png

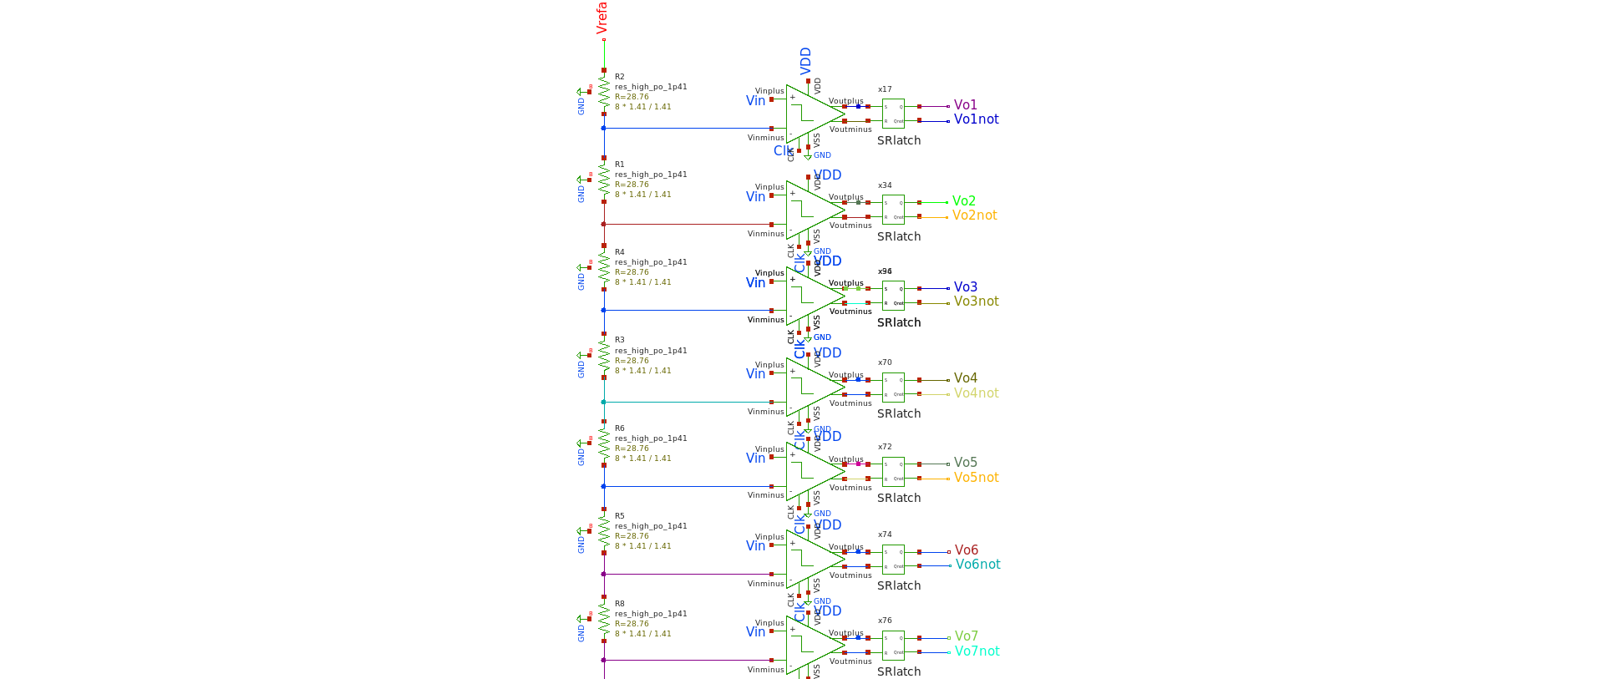
ADCschSmallPart.png
