gmoorman/sddec24-13/xschem/DataConverters/Priority_Encoder_16t4.v

module Priority_Encoder_16t4 (VGND,
    VPWR,
    in0,
    in1,
    in10,
    in11,
    in12,
    in13,
    in14,
    in15,
    in2,
    in3,
    in4,
    in5,
    in6,
    in7,
    in8,
    in9,
    out0,
    out1,
    out2,
    out3);
 input VGND;
 input VPWR;
 input in0;
 input in1;
 input in10;
 input in11;
 input in12;
 input in13;
 input in14;
 input in15;
 input in2;
 input in3;
 input in4;
 input in5;
 input in6;
 input in7;
 input in8;
 input in9;
 output out0;
 output out1;
 output out2;
 output out3;

 wire _00_;
 wire _01_;
 wire _02_;
 wire _03_;
 wire _04_;
 wire _05_;
 wire _06_;
 wire _07_;
 wire _08_;
 wire _09_;
 wire _10_;
 wire _11_;
 wire _12_;
 wire _13_;
 wire _14_;
 wire _15_;
 wire net1;
 wire net10;
 wire net11;
 wire net12;
 wire net13;
 wire net14;
 wire net15;
 wire net16;
 wire net17;
 wire net18;
 wire net19;
 wire net2;
 wire net3;
 wire net4;
 wire net5;
 wire net6;
 wire net7;
 wire net8;
 wire net9;

 sky130_fd_sc_hd__decap_8 FILLER_0_0_19 (.VGND(VGND),
    .VNB(VGND),
    .VPB(VPWR),
    .VPWR(VPWR));
 sky130_fd_sc_hd__fill_1 FILLER_0_0_27 (.VGND(VGND),
    .VNB(VGND),
    .VPB(VPWR),
    .VPWR(VPWR));
 sky130_fd_sc_hd__decap_8 FILLER_0_0_29 (.VGND(VGND),
    .VNB(VGND),
    .VPB(VPWR),
    .VPWR(VPWR));
 sky130_fd_sc_hd__fill_2 FILLER_0_0_37 (.VGND(VGND),
    .VNB(VGND),
    .VPB(VPWR),
    .VPWR(VPWR));
 sky130_fd_sc_hd__fill_2 FILLER_0_0_54 (.VGND(VGND),
    .VNB(VGND),
    .VPB(VPWR),
    .VPWR(VPWR));
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
    .VPWR(VPWR),
    .X(out1));
 sky130_fd_sc_hd__buf_12 output18 (.A(net18),
    .VGND(VGND),
    .VNB(VGND),
    .VPB(VPWR),
    .VPWR(VPWR),
    .X(out2));
 sky130_fd_sc_hd__buf_12 output19 (.A(net19),
    .VGND(VGND),
    .VNB(VGND),
    .VPB(VPWR),
    .VPWR(VPWR),
    .X(out3));
endmodule
