gmoorman/sddec24-13/(commit log)

2025-01-09 Organized Xschem and Mag, still need to make README and push Verilog and .tcl stuff but VMWare is still down
    [1T1R.sch, 1T1R2.sch, 1T1Rc.sch, 1T1Rres.sch, 1bitADC.sch, 1t1rTB.sch, 1t1rTBregular.sch, 1t1rresTB.sch]
2025-01-29 Added Flash ADC layout + dependencies and tcl script used for comparator layout
2025-01-29 Added all of Gage's Xschem stuff and fixed symbol paths
    [1t1rTB.sch, 1t1rTBregular.sch, 1t1rresTB.sch, 2x2.sch, 2x2comp.sch, 2x2crossbar.sch, 3bitADC.sch, 4bitADCtb.sch]
2025-02-03 Added Final schematics from Gage2
    [Analogmux2.sch, FinalSch.sch, PeriperyCircuit.sch, PeripheryCircuit.sch, mux3analog.sch]
